uFahrrad/tandem-devkit/project-lib/3dmodels/hub-wire-connector.step

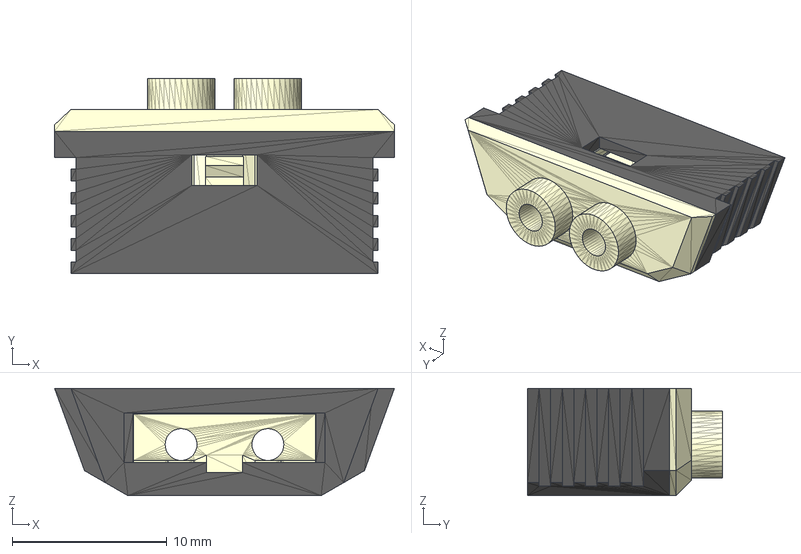
[picture p1: CAD file, 2022-06-10]
project-lib/3dmodels/hub-wire-connector.step
22.0 x 12.6 x 6.95 mm
Cover001 (Solid)
Contact_housing001 (Solid)
