uFahrrad/tandem-devkit/tandem-devkit.kicad_pcb

## KiCad design tandem-devkit.kicad_pcb (2022-06-21)

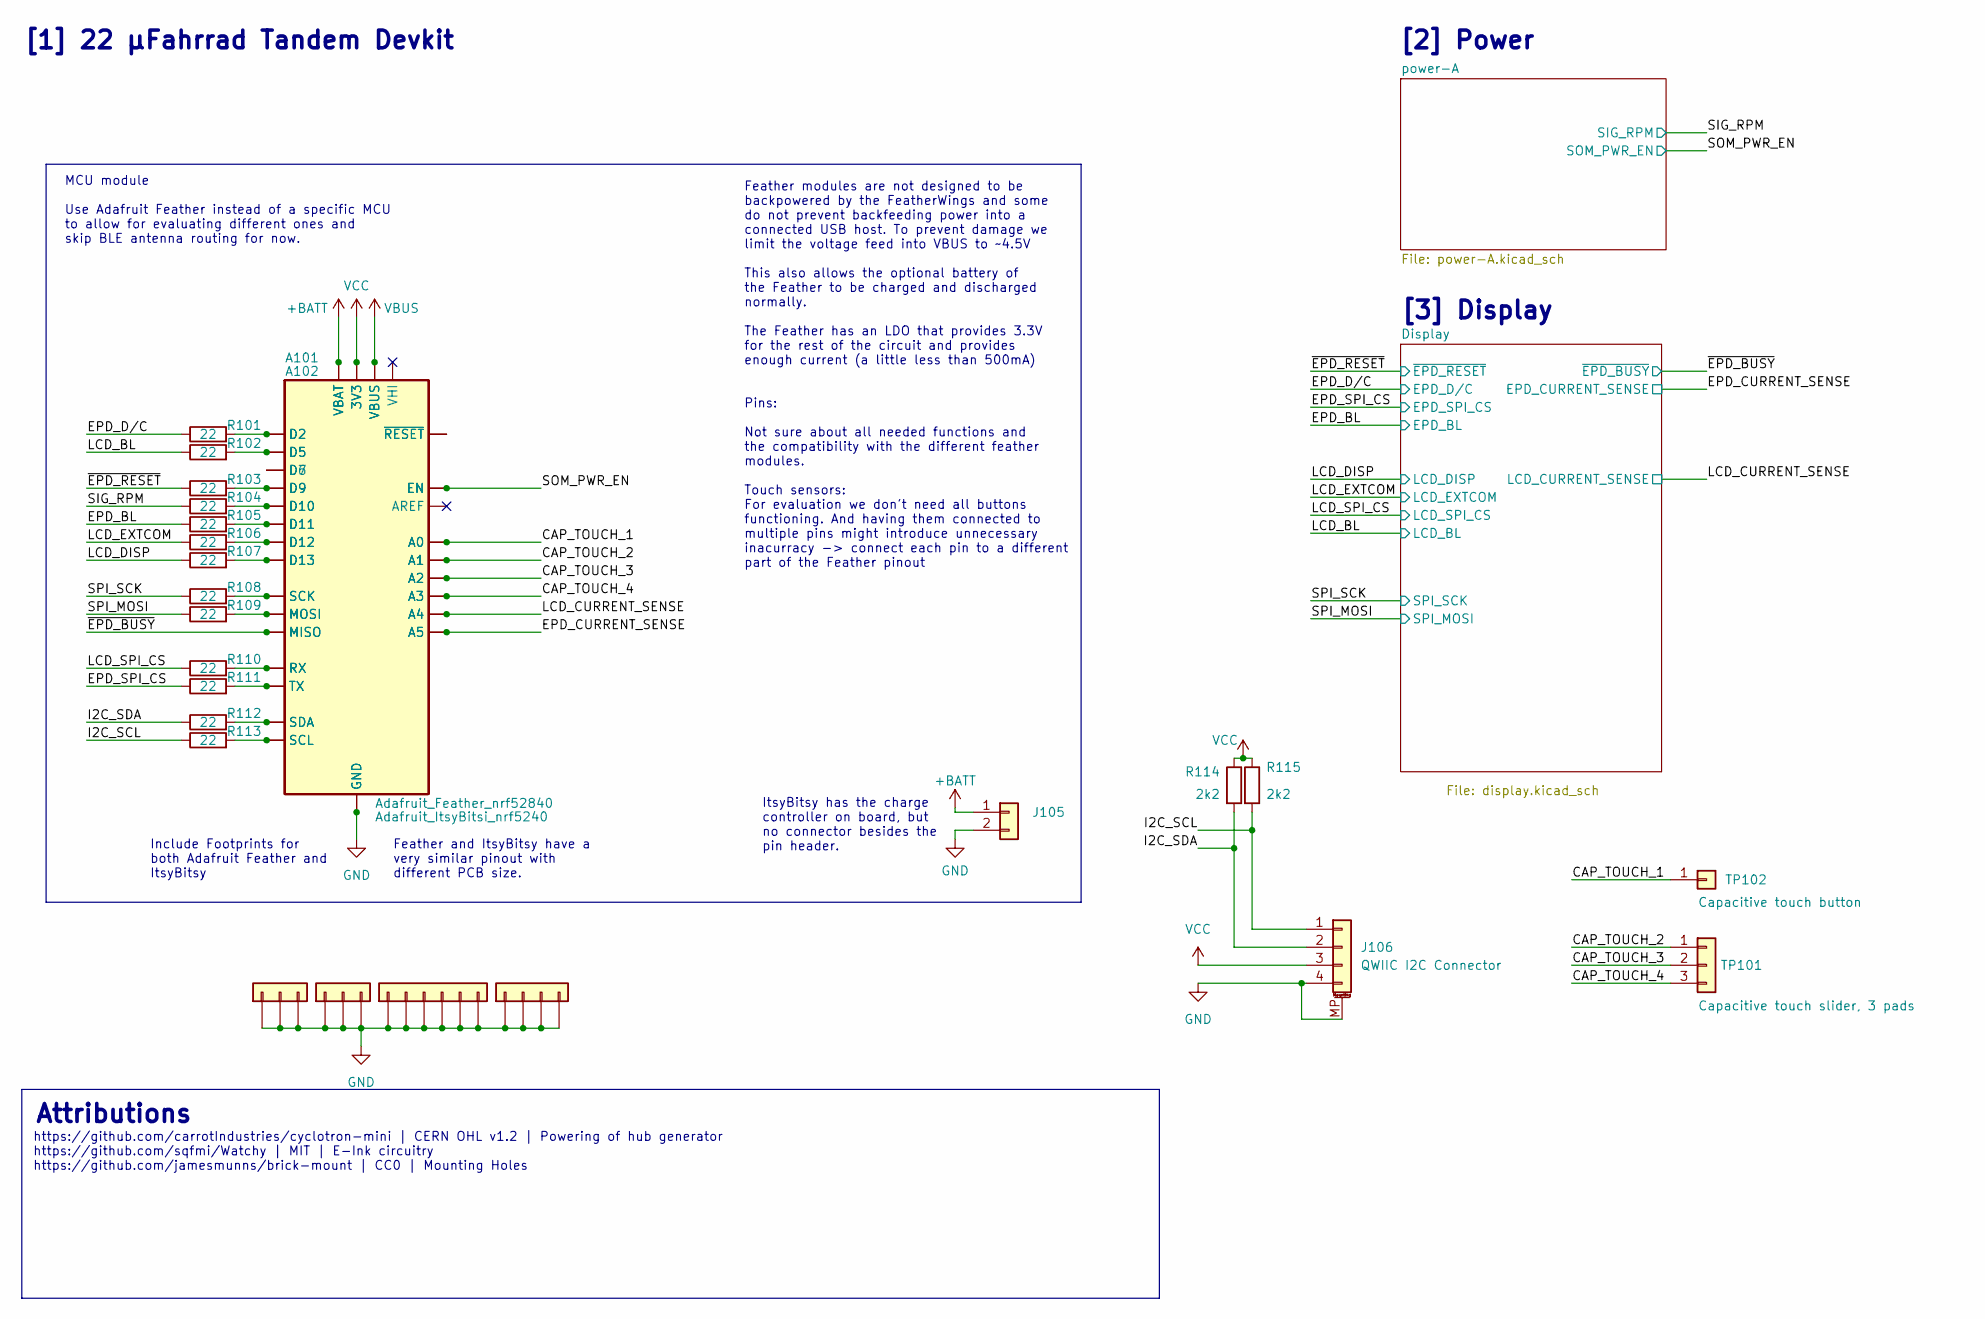
[picture p2: schematic tandem-devkit.kicad_sch, 22 μFahrrad Tandem Devkit]

Parts:
A101: Adafruit_ItsyBitsi_nrf5240; Adafruit_ItsyBitsy-nrf52840
A102: Adafruit_Feather_nrf52840; Adafruit_Feather
J101, J102: Conn_01x03; brick-1x3
J103: Conn_01x06; brick-1x6
J104: Conn_01x04; brick-2x2
J105: Conn_01x02; JST_PH_B2B-PH-K_1x02_P2.00mm_Vertical; JLCPCB C173752
J106: QWIIC I2C Connector; JST_SHL_SM04B-SHLS-TF_1x04-1MP_P1.00mm_Horizontal; JLCPCB C145956
R101, R102, R103, R104, R105, R106, R107, R108, R109, R110, R111, R112, R113: 22; R_0603_1608Metric; LCSC C23345
R114, R115: 2k2; R_0603_1608Metric; LCSC C4190
TP101: Capacitive touch slider, 3 pads; TouchSlider-3_30x13mm-covered
TP102: Capacitive touch button; CapBtn_Board_edge

Connections:
+BATT: A101.28 (VBAT), A102.28 (VBAT), J105.1
/CAP_TOUCH_1: A101.5 (A0), A102.5 (A0), TP102.1
/CAP_TOUCH_2: A101.6 (A1), A102.6 (A1), TP101.1; also elsewhere on the board
/CAP_TOUCH_3: A101.7 (A2), A102.7 (A2), TP101.2; also elsewhere on the board
/CAP_TOUCH_4: A101.8 (A3), A102.8 (A3), TP101.3; also elsewhere on the board
/EPD_BL: R105.1; also elsewhere on the board
/EPD_CURRENT_SENSE: A101.10 (A5), A102.10 (A5); also elsewhere on the board
/EPD_D/C: R101.1; also elsewhere on the board
/EPD_SPI_CS: R111.1; also elsewhere on the board
/I2C_SCL: J106.1, R113.1, R115.2
/I2C_SDA: J106.2, R112.1, R114.2
/LCD_BL: R102.1; also elsewhere on the board
/LCD_CURRENT_SENSE: A101.9 (A4), A102.9 (A4); also elsewhere on the board
/LCD_DISP: R107.1; also elsewhere on the board
/LCD_EXTCOM: R106.1; also elsewhere on the board
/LCD_SPI_CS: R110.1; also elsewhere on the board
/SIG_RPM: R104.1; also elsewhere on the board
/SOM_PWR_EN: A101.3 (EN), A102.27 (EN); also elsewhere on the board
/SPI_MOSI: R109.1; also elsewhere on the board
/SPI_SCK: R108.1; also elsewhere on the board
/~EPD_BUSY: A101.13 (MISO), A102.13 (MISO); also elsewhere on the board
/~EPD_RESET: R103.1; also elsewhere on the board
GND: A101.27 (GND), A102.4 (GND), J101.1, J101.2, J101.3, J102.1, J102.2, J102.3, J103.1, J103.2, J103.3, J103.4, J103.5, J103.6, J104.1, J104.2, J104.3, J104.4, J105.2, J106.4, J106.MP (MountPin); also elsewhere on the board
unnamed: A101.1 (~RESET), A102.1 (~RESET)
unnamed: A101.11 (SCK), A102.11 (SCK), R108.2
unnamed: A101.12 (MOSI), A102.12 (MOSI), R109.2
unnamed: A101.14 (D2), A102.16 (D2), R101.2
unnamed: A101.15 (RX), A102.14 (RX), R110.2
unnamed: A101.16 (TX), A102.15 (TX), R111.2
unnamed: A101.17 (SDA), A102.17 (SDA), R112.2
unnamed: A101.18 (SCL), A102.18 (SCL), R113.2
unnamed: A101.19 (D5), A102.19 (D5), R102.2
unnamed: A101.20 (D7), A102.20 (D6)
unnamed: A101.21 (D9), A102.21 (D9), R103.2
unnamed: A101.22 (D10), A102.22 (D10), R104.2
unnamed: A101.23 (D11), A102.23 (D11), R105.2
unnamed: A101.24 (D12), A102.24 (D12), R106.2
unnamed: A101.25 (D13), A102.25 (D13), R107.2
VBUS: A101.26 (VBUS), A102.26 (VBUS); also elsewhere on the board
VCC: A101.2 (3V3), A102.2 (3V3), J106.3, R114.1, R115.1; also elsewhere on the board

Notes on the sheet:
Include Footprints for both Adafruit Feather and ItsyBitsy
ItsyBitsy has the charge controller on board, but no connector besides the pin header.
[2] Power
https://github.com/carrotIndustries/cyclotron-mini | CERN OHL v1.2 | Powering of hub generator https://github.com/sqfmi/Watchy | MIT | E-Ink circuitry https://github.com/jamesmunns/brick-mount | CC0 | Mounting Holes
MCU module Use Adafruit Feather instead of a specific MCU to allow for evaluating different ones and skip BLE antenna routing for now.
[3] Display
Attributions
Feather and ItsyBitsy have a very similar pinout with different PCB size.
Pins: Not sure about all needed functions and the compatibility with the different feather modules. Touch sensors: For evaluation we don't need all buttons functioning. And having them connected to multiple pins might introduce unnecessary inacurracy -> connect each pin to a different part of the F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
[1] 22 μFahrrad Tandem Devkit
Feather modules are not designed to be backpowered by the FeatherWings and some do not prevent backfeeding power into a connected USB host. To prevent damage we limit the voltage feed into VBUS to ~4.5V This also allows the optional battery of the Feather to be charged and discharged normally. The 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

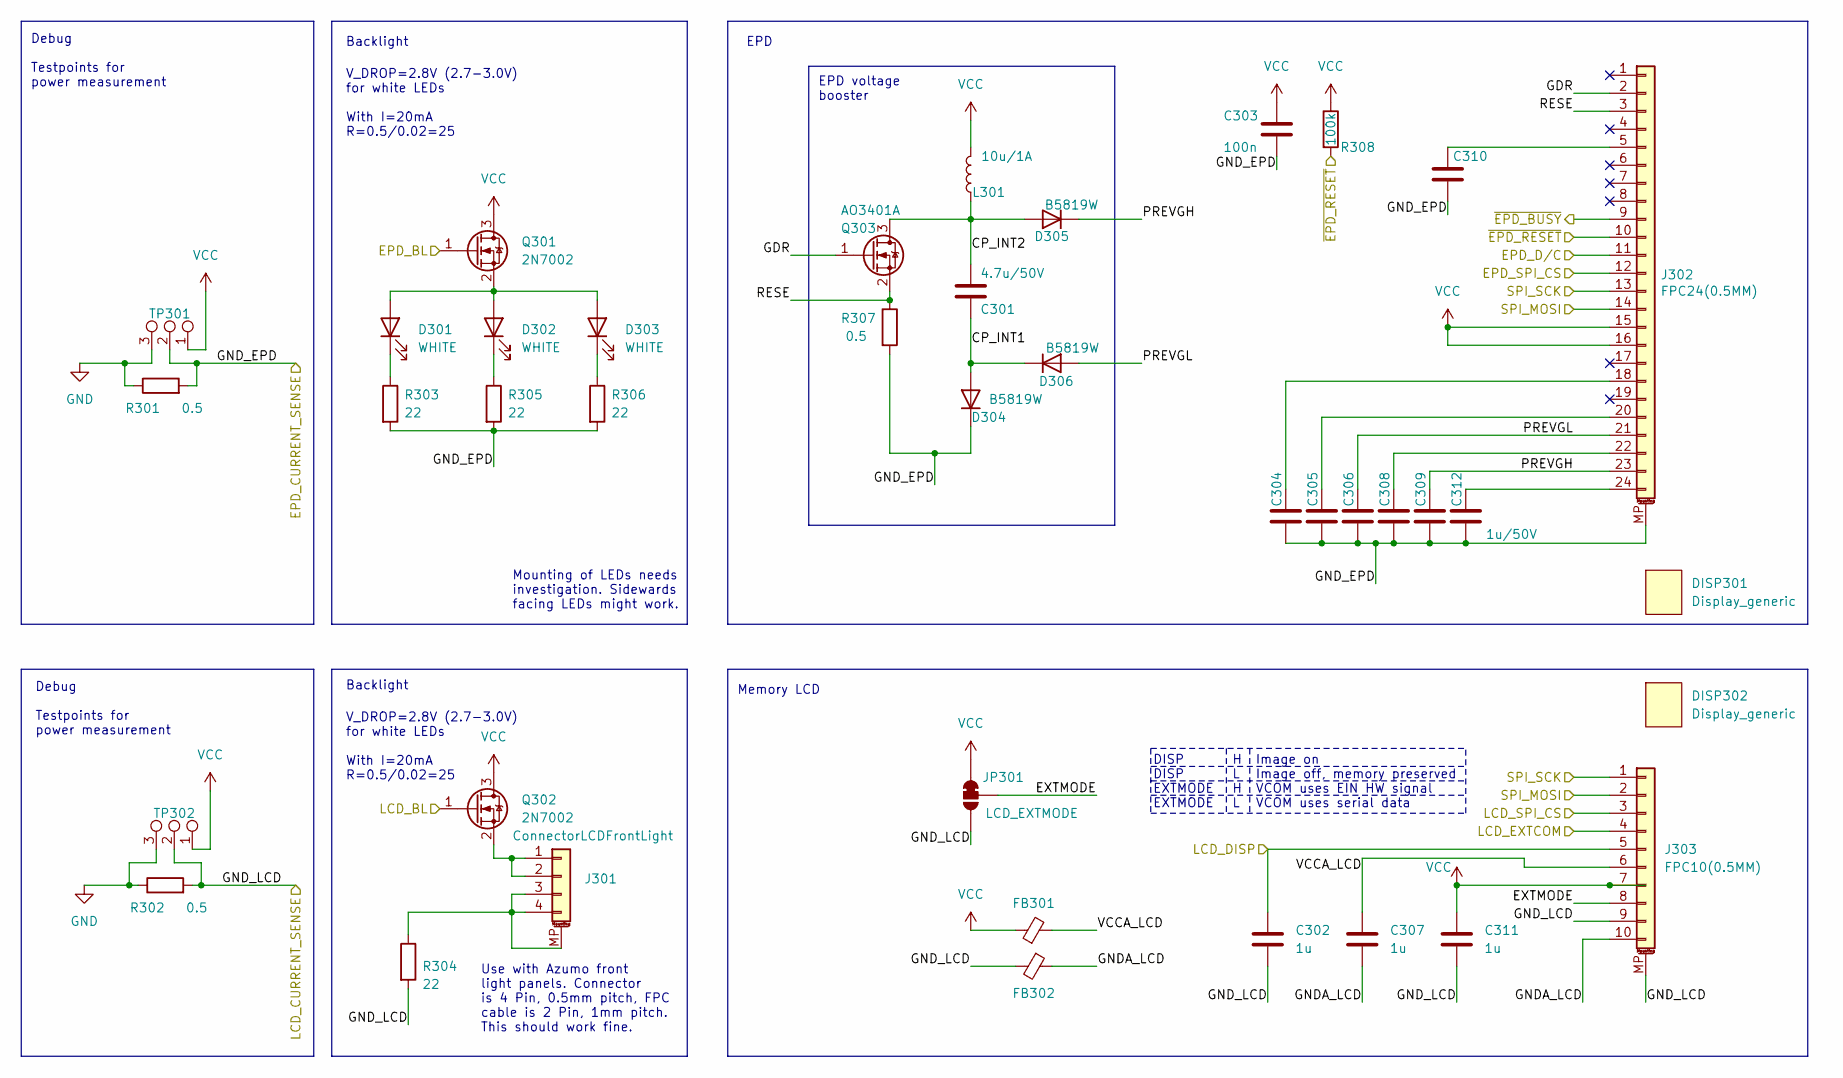
[picture p3: schematic display.kicad_sch, 22 μFahrrad Tandem Devkit - Display]

Parts:
C301: 4.7u/50V; C_1206_3216Metric; LCSC C29823
C302, C307, C311: 1u; C_0603_1608Metric; LCSC C15849
C303: 100n; C_0603_1608Metric; LCSC C14663
C304, C305, C306, C308, C309, C310, C312: 1u/50V; C_0603_1608Metric; LCSC C15849
D301, D302, D303: WHITE; LED_sidemount_C205440; JLCPCB C965863
D304, D305, D306: B5819W; D_SOD-123; JLCPCB C8598
DISP301, DISP302: Display_generic; 154_Epaper_Display
FB301, FB302: FerriteBead_Small; R_0805_2012Metric; JLCPCB C1017
J301: ConnectorLCDFrontLight; jlcpcb-C11047_FFC_1x04-1MP_P0.50mm_Horizontal; JLCPCB C11047
J302: FPC24(0.5MM); jlcpcb-C11057_FFC_1x24-1MP_P0.50mm_Horizontal; JLCPCB C11057
J303: FPC10(0.5MM); jlcpcb-C11050_FFC_1x10-1MP_P0.50mm_Horizontal; JLCPCB C11050
JP301: LCD_EXTMODE; SolderJumper-3_P1.3mm_Bridged12_RoundedPad1.0x1.5mm
L301: 10u/1A; L_4.0x4.0_H3; JLCPCB C38117
Q301, Q302: 2N7002; SOT-23; JLCPCB C8545
Q303: AO3401A; SOT-23; JLCPCB C15127
R301, R302: 0.5; R_0805_2012Metric; JLCPCB C25271
R303, R304, R305, R306: 22; R_0603_1608Metric; LCSC C23345
R307: 0.5; R_0805_2012Metric; LCSC C28319
R308: 100k; R_0603_1608Metric; LCSC C25803
TP301, TP302: TestPoint_3Pole; TestPoint_1x03_P1.27mm

Connections:
/Display/CP_INT1: C301.2, D304.2 (A), D306.1 (K)
/Display/CP_INT2: C301.1, D305.2 (A), L301.1, Q303.3 (D)
/Display/EXTMODE: J303.8, JP301.2 (C)
/Display/GDR: J302.2, Q303.1 (G)
/Display/GNDA_LCD: C307.2, FB302.1, J303.10
/Display/PREVGH: C309.2, D305.1 (K), J302.23
/Display/PREVGL: C306.2, D306.2 (A), J302.21
/Display/RESE: J302.3, Q303.2 (S), R307.1
/Display/VCCA_LCD: C307.1, FB301.2, J303.6
/EPD_BL: Q301.1 (G); also elsewhere on the board
/EPD_CURRENT_SENSE: C303.2, C304.1, C305.1, C306.1, C308.1, C309.1, C310.2, C312.1, D304.1 (K), J302.MP (MountPin), R301.2, R303.2, R305.2, R306.2, R307.2, TP301.2; also elsewhere on the board
/EPD_D/C: J302.11; also elsewhere on the board
/EPD_SPI_CS: J302.12; also elsewhere on the board
/LCD_BL: Q302.1 (G); also elsewhere on the board
/LCD_CURRENT_SENSE: C302.2, C311.2, FB302.2, J303.9, J303.MP (MountPin), JP301.3 (B), R302.2, R304.2, TP302.2; also elsewhere on the board
/LCD_DISP: C302.1, J303.5; also elsewhere on the board
/LCD_EXTCOM: J303.4; also elsewhere on the board
/LCD_SPI_CS: J303.3; also elsewhere on the board
/SPI_MOSI: J302.14, J303.2; also elsewhere on the board
/SPI_SCK: J302.13, J303.1; also elsewhere on the board
/~EPD_BUSY: J302.9; also elsewhere on the board
/~EPD_RESET: J302.10, R308.2; also elsewhere on the board
GND: R301.1, R302.1, TP301.3, TP302.3; also elsewhere on the board
unnamed: C304.2, J302.18
unnamed: C305.2, J302.20
unnamed: C308.2, J302.22
unnamed: C310.1, J302.5
unnamed: C312.2, J302.24
unnamed: D301.1 (K), R303.1
unnamed: D301.2 (A), D302.2 (A), D303.2 (A), Q301.2 (S)
unnamed: D302.1 (K), R305.1
unnamed: D303.1 (K), R306.1
unnamed: J301.1, J301.2, Q302.2 (S)
unnamed: J301.3, J301.4, J301.MP (MountPin), R304.1
VCC: C303.1, C311.1, FB301.1, J302.15, J302.16, J303.7, JP301.1 (A), L301.2, Q301.3 (D), Q302.3 (D), R308.1, TP301.1, TP302.1; also elsewhere on the board

Notes on the sheet:
Image on Image off, memory preserved VCOM uses EIN HW signal VCOM uses serial data
H L H L
V_DROP=2.8V (2.7-3.0V) for white LEDs With I=20mA R=0.5/0.02=25
Use with Azumo front light panels. Connector is 4 Pin, 0.5mm pitch, FPC cable is 2 Pin, 1mm pitch. This should work fine.
Debug Testpoints for power measurement
Mounting of LEDs needs investigation. Sidewards facing LEDs might work.
Backlight
EPD
DISP DISP EXTMODE EXTMODE
Memory LCD
EPD voltage booster

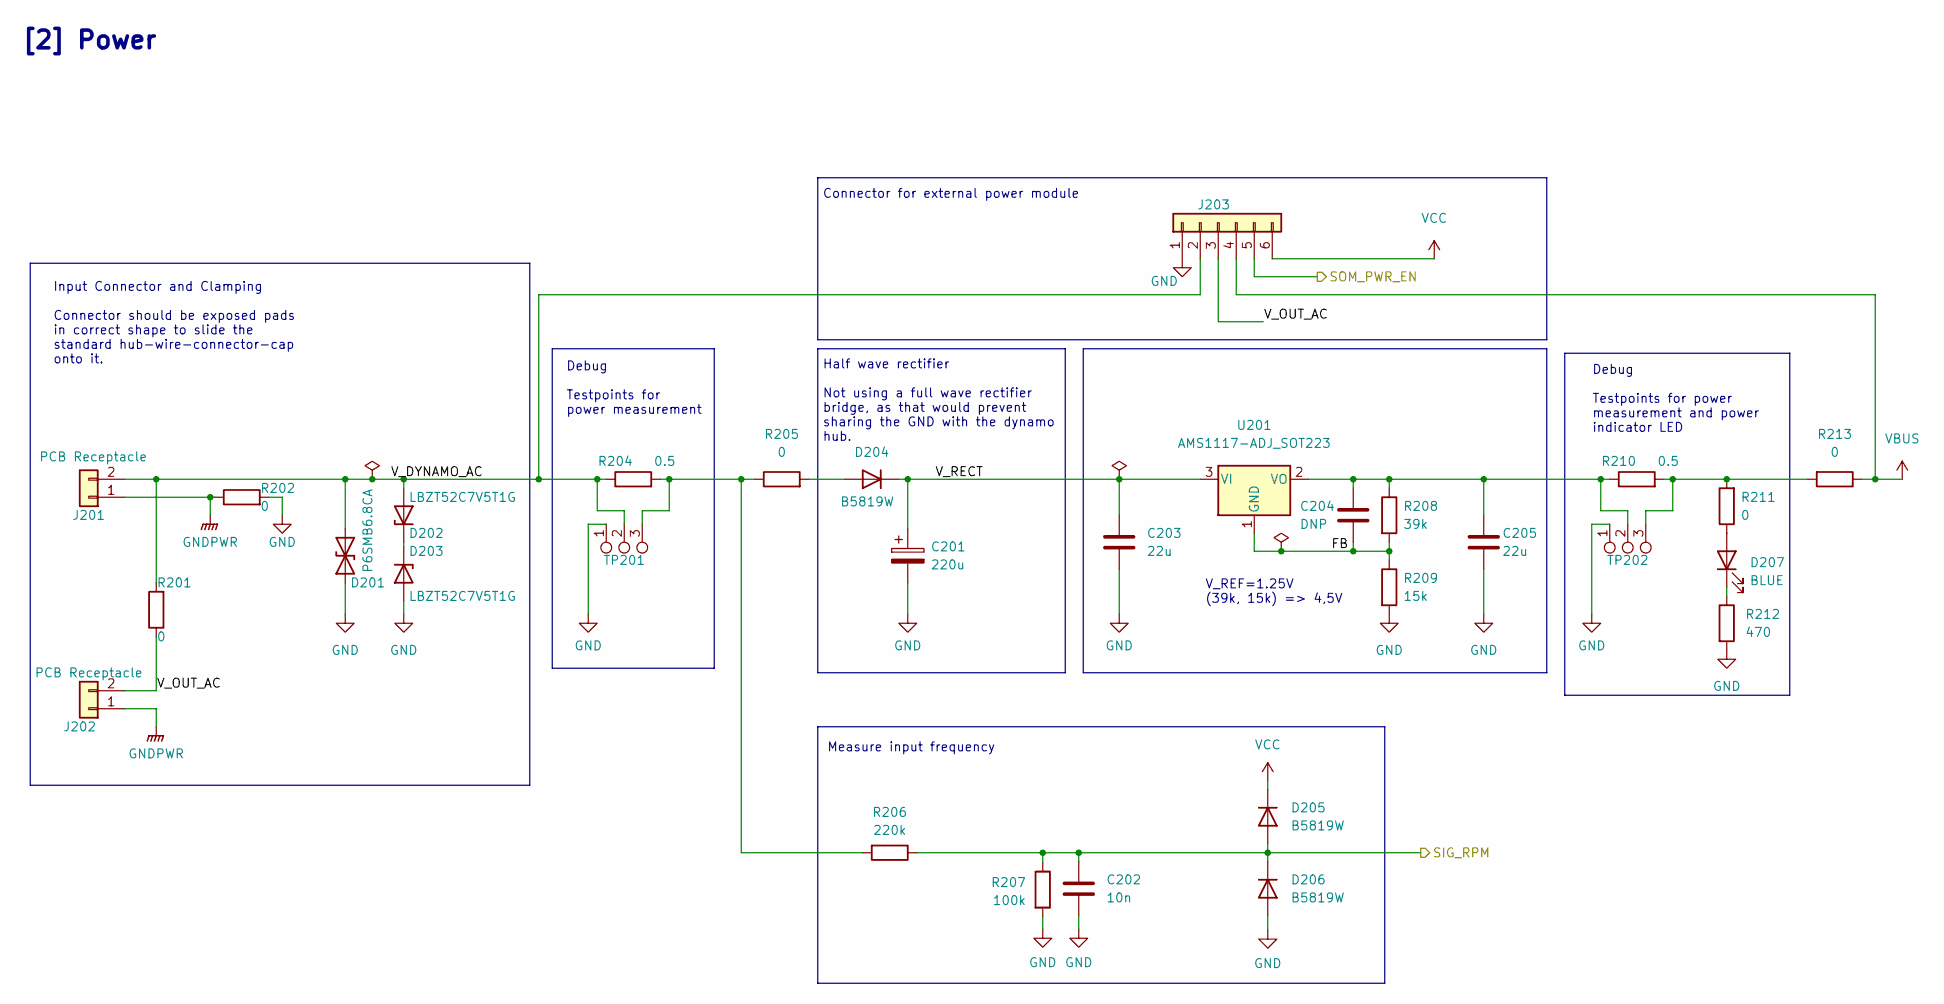
[picture p4: schematic power-A.kicad_sch, 22 μFahrrad Tandem Devkit - Power]

Parts:
C201: 220u; CP_EIA-7343-43_Kemet-X; JLCPCB C117040
C202: 10n; C_0603_1608Metric; LCSC C57112
C203, C205: 22u; C_1206_3216Metric; JLCPCB C12891
C204: DNP; C_0603_1608Metric
D201: P6SMB6.8CA; D_SMB; JLCPCB C78395
D202, D203: LBZT52C7V5T1G; D_SOD-123; JLCPCB C12760
D204, D205, D206: B5819W; D_SOD-123; JLCPCB C8598
D207: BLUE; LED_0603_1608Metric; JLCPCB C2293
J201, J202: PCB Receptacle; shimano-hub-generator-connector
J203: Conn_01x06; powermodule
R201, R202, R205, R211, R213: 0; R_0805_2012Metric_Pad1.20x1.40mm_HandSolder; LCSC C17477
R204, R210: 0.5; R_0805_2012Metric; JLCPCB C25271
R206: 220k; R_0603_1608Metric; LCSC C22961
R207: 100k; R_0603_1608Metric; LCSC C25803
R208: 39k; R_0603_1608Metric; LCSC C23153
R209: 15k; R_0603_1608Metric; LCSC C22809
R212: 470; R_0603_1608Metric; LCSC C23179
TP201, TP202: TestPoint_3Pole; TestPoint_1x03_P1.27mm
U201: AMS1117-ADJ_SOT223; SOT-223-3_TabPin2; JLCPCB C347224

Connections:
/SIG_RPM: C202.1, D205.2 (A), D206.1 (K), R206.1, R207.1; also elsewhere on the board
/SOM_PWR_EN: J203.5; also elsewhere on the board
/power-A/FB: C204.2, R208.2, R209.1, U201.1 (GND)
/power-A/V_DYNAMO_AC: D201.2 (A2), D202.2 (A), J201.2, J203.2, R201.2, R204.1, TP201.2
/power-A/V_OUT_AC: J202.2, J203.3, R201.1
/power-A/V_RECT: C201.1, C203.1, D204.1 (K), U201.3 (VI)
GND: C201.2, C202.2, C203.2, C205.2, D201.1 (A1), D203.2 (A), D206.2 (A), J203.1, R202.2, R207.2, R209.2, R212.2, TP201.1, TP202.1; also elsewhere on the board
GNDPWR: J201.1, J202.1, R202.1
unnamed: C204.1, C205.1, R208.1, R210.1, TP202.2, U201.2 (VO)
unnamed: D202.1 (K), D203.1 (K)
unnamed: D204.2 (A), R205.2
unnamed: D207.1 (K), R212.1
unnamed: D207.2 (A), R211.1
unnamed: R204.2, R205.1, R206.2, TP201.3
unnamed: R210.2, R211.2, R213.2, TP202.3
VBUS: J203.4, R213.1; also elsewhere on the board
VCC: D205.1 (K), J203.6; also elsewhere on the board

Notes on the sheet:
Debug Testpoints for power measurement
V_REF=1.25V (39k, 15k) => 4,5V
Connector for external power module
Debug Testpoints for power measurement and power indicator LED
Half wave rectifier Not using a full wave rectifier bridge, as that would prevent sharing the GND with the dynamo hub.
Measure input frequency
Input Connector and Clamping Connector should be exposed pads in correct shape to slide the standard hub-wire-connector-cap onto it.
[2] Power

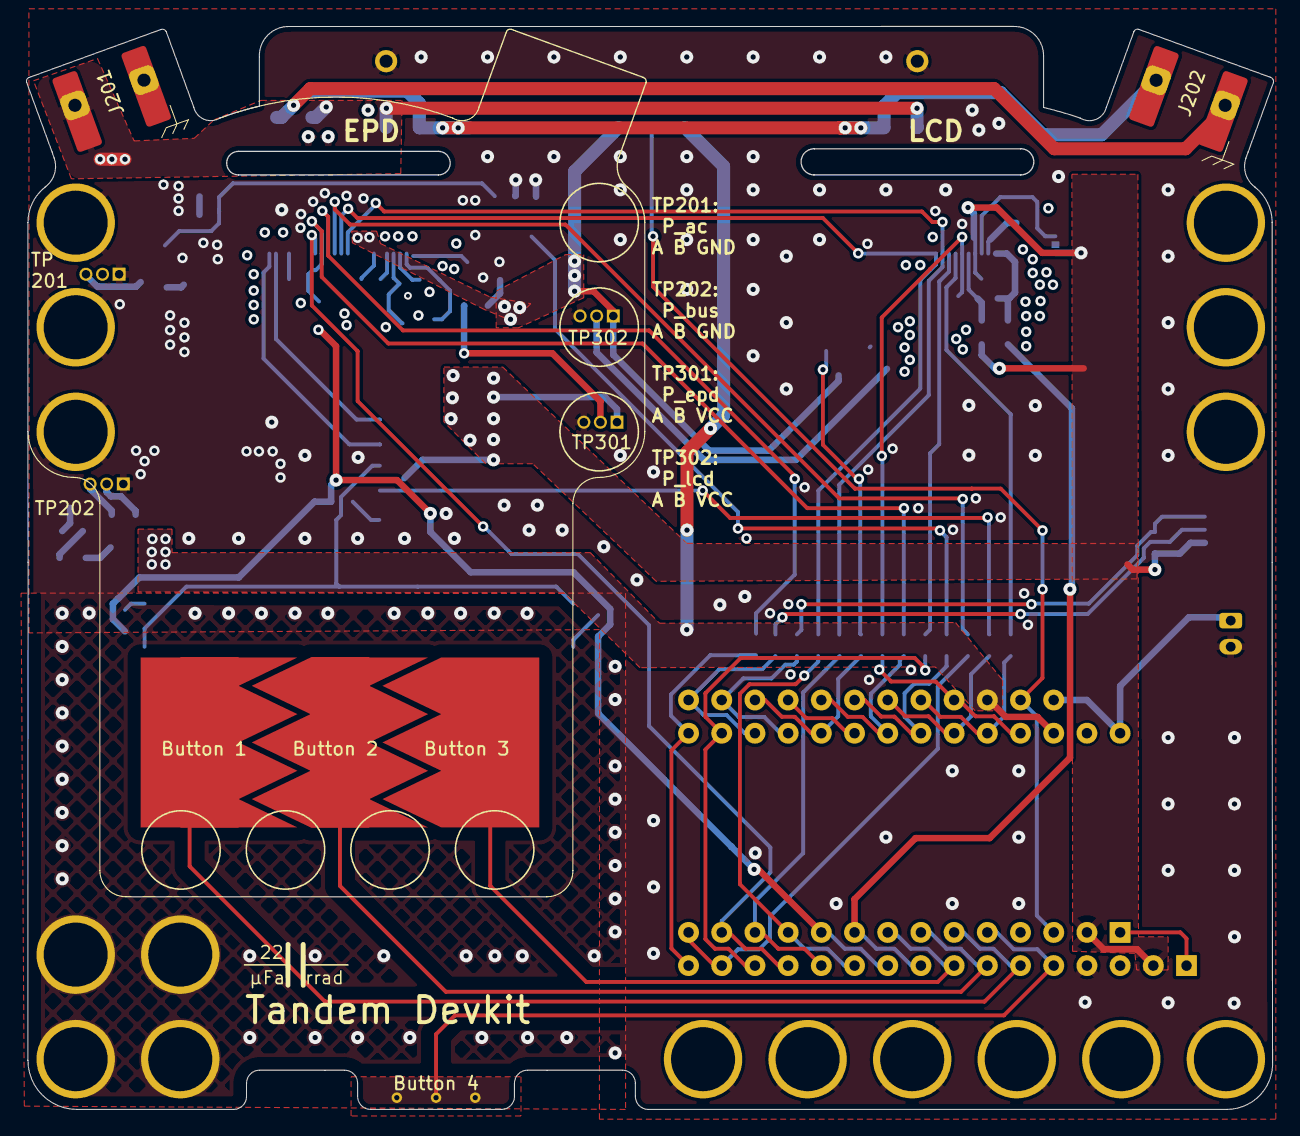
[picture p5: board tandem-devkit.kicad_pcb from above]

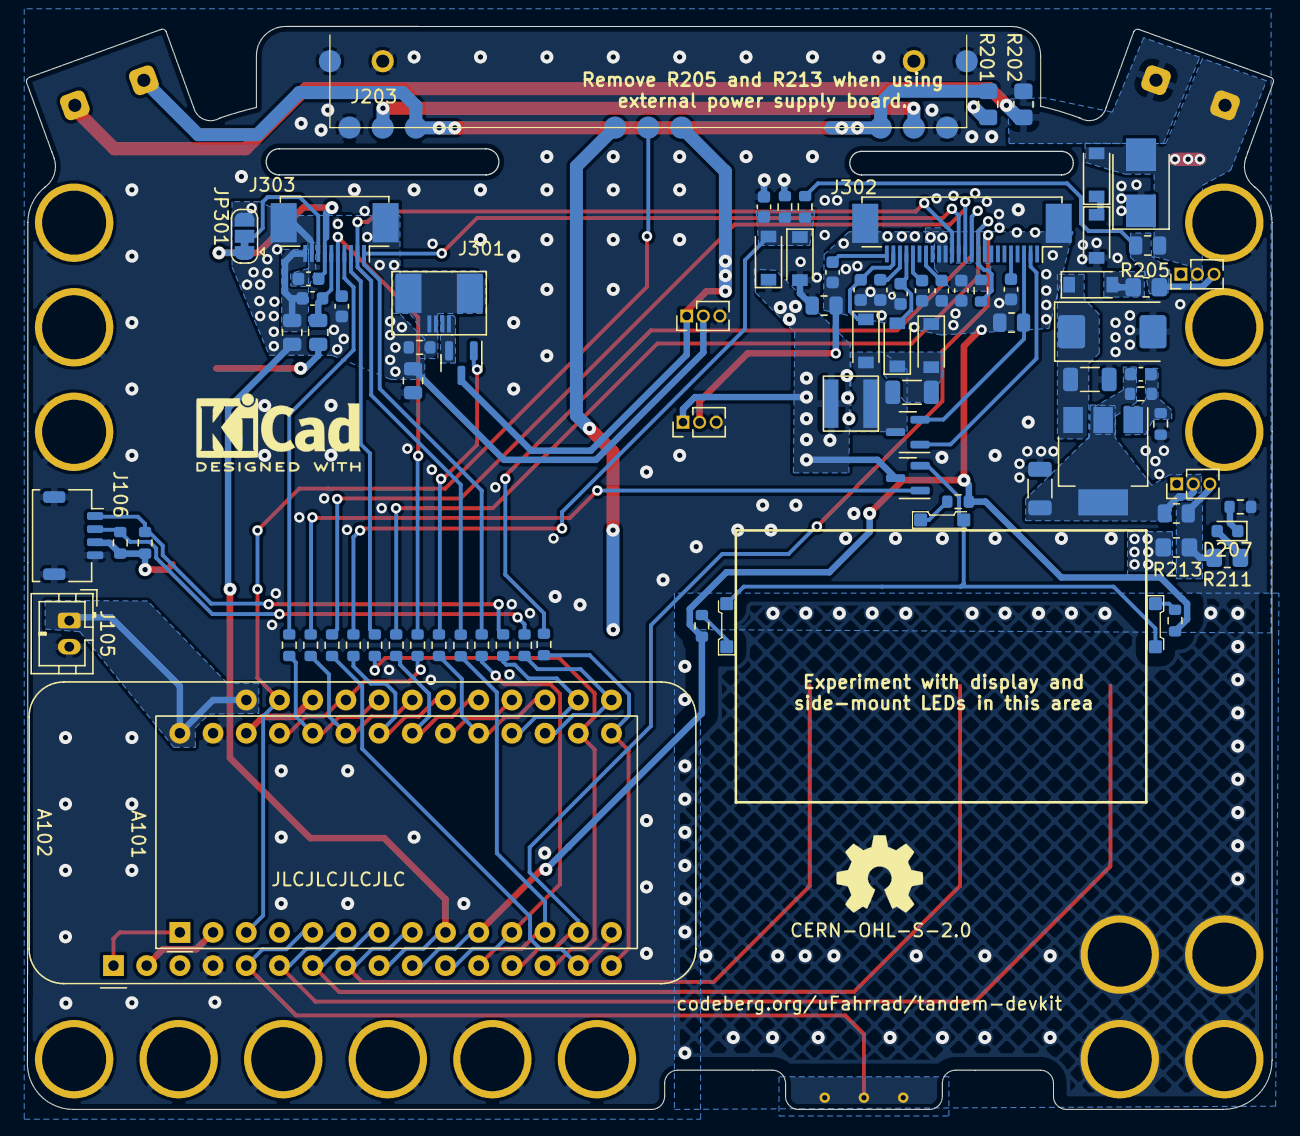
[picture p6: board tandem-devkit.kicad_pcb from below]

Board: 4 copper layers, 95.4 x 82.9 mm, 99 parts (91 on the bottom side), 72 nets.

Other parts of the board:
22uFahrrad-Logo: LOGO
BoardOutline: μFahrrad-DevTandem-Shape
KiCAD-Logo: KiCad-Logo2_5mm_SilkScreen
OSHW-Logo: OSHW-Symbol_6.7x6mm_SilkScreen
locked: Capacitive touch slider, 3 pads; TouchSlider-3_30x13mm-covered

Their connections:
/CAP_TOUCH_2: locked.1; also elsewhere on the board
/CAP_TOUCH_3: locked.2; also elsewhere on the board
/CAP_TOUCH_4: locked.3; also elsewhere on the board
