uFahrrad/tandem-devkit/(commit log)

2022-06-10 Initial Commit with kicad-git-filters setup
2022-06-10 Add kicad_pcb-diff tooling
2022-06-10 Addd schematic
    [display.kicad_sch, power-A.kicad_sch, tandem-devkit.kicad_sch]
2022-06-10 Add WIP PCB layout
    [tandem-devkit.kicad_pcb]
2022-06-10 Add project library
    [hub-wire-connector.step]
2022-06-20 gitginore kicad_prl file
2022-06-20 Pre routing: footprints&parts
    [display.kicad_sch, power-A.kicad_sch, tandem-devkit.kicad_pcb, tandem-devkit.kicad_sch]
2022-06-20 Schematics: Add mountingpins to connectors, remove ERC warnings for alternate parts
    [display.kicad_sch, power-A.kicad_sch, tandem-devkit.kicad_sch]
2022-06-20 ERC: allow multiple net names for display GND/current_sense nets
2022-06-20 footprints: add mounting pins to FPC connectors
2022-06-20 PCB: include schematic changes
    [tandem-devkit.kicad_pcb]
2022-06-20 schematic: replace LCD Light with connector for Azumo light panel
    [display.kicad_sch, power-A.kicad_sch, tandem-devkit.kicad_sch]
2022-06-20 footprints: add needed footprints for backlight LED and connector
2022-06-20 schematic: add placeholders for the actual displays
    Also fixup GND_LCD for Extmode SolderJumper.
    [display.kicad_sch, tandem-devkit.kicad_sch]
2022-06-20 schematic: GND_EPD fixups
    [display.kicad_sch, tandem-devkit.kicad_sch]
2022-06-20 footprints: fixup courtyard of inductors
2022-06-20 PCB: rough placement, 1/x
    [tandem-devkit.kicad_pcb]
2022-06-20 schematic: cleanups and diode selection
    [display.kicad_sch, power-A.kicad_sch, tandem-devkit.kicad_sch]
2022-06-20 PCB: rough placement, 2/x
    [tandem-devkit.kicad_pcb]
2022-06-20 PCB: rough placement, 3/x
    [tandem-devkit.kicad_pcb]
2022-06-20 footprints: define testpoint with smaller courtyard
    [display.kicad_sch, power-A.kicad_sch, tandem-devkit.kicad_sch]
2022-06-20 schematic: fixup reference designator positions
    [tandem-devkit.kicad_sch]
2022-06-20 schematic: add another capacitive touch point, reorder feather pins
    [display.kicad_sch, tandem-devkit.kicad_sch]
2022-06-20 PCB: flip feather so it can be soldered directly underneath the board
    [tandem-devkit.kicad_pcb]
2022-06-20 PCB: update netlist
    [tandem-devkit.kicad_pcb]
2022-06-20 PCB: reorder a little, move all feather/itsy-bitsy internal connections to single copper layer
    [tandem-devkit.kicad_pcb]
2022-06-20 PCB: import JLCPCB 4-Layer board settings
    [tandem-devkit.kicad_pcb]
2022-06-20 PCB: fix DRC
    - reduced track clearance for power and default net to fit between
    the pads of connectors
    - rearranged epaper driver to adhere to DRC rules
    - connected Feather and ItsyBitsy footprint and the related resistors
    [tandem-devkit.kicad_pcb]
2022-06-20 schematic: fix LCD VCCA decoupling capacitor
    [display.kicad_sch]
2022-06-20 PCB: route display connectors
    [tandem-devkit.kicad_pcb]
2022-06-20 schematic: switch EPD/LCD current sense lines to ease routing
    [tandem-devkit.kicad_sch]
2022-06-20 PCB: routing mostly done
    [tandem-devkit.kicad_pcb]
2022-06-20 PCB: fix most of zone priorities and connections
    [tandem-devkit.kicad_pcb]
2022-06-20 schematic: assign connector footprint
    [power-A.kicad_sch, tandem-devkit.kicad_sch]
2022-06-20 PCB/footprints: Update shape and connector
    [tandem-devkit.kicad_pcb]
2022-06-20 Exchange brick-mount holes with actual footprint, connect holes to gnd
    [display.kicad_sch, tandem-devkit.kicad_pcb, tandem-devkit.kicad_sch]
2022-06-20 connect everything except the capacitive touch sensors
    [tandem-devkit.kicad_pcb, tandem-devkit.kicad_sch]
2022-06-20 prepare for touch button routing
    [tandem-devkit.kicad_pcb, tandem-devkit.kicad_sch]
2022-06-20 PCB: route cap buttons and adjust zones
    [tandem-devkit.kicad_sch]
2022-06-20 PCB: align testpoint orientation with silkscreen
2022-06-20 PCB: Touchbuttons and silkscreen adaptions
    [tandem-devkit.kicad_sch]
2022-06-20 Footprints: add forgotten footprints to git
2022-06-20 Schematic: more 0R resistors and power module connector
    [power-A.kicad_sch, tandem-devkit.kicad_sch]
2022-06-20 PCB: add powermodule and reroute some stuff
    [power-A.kicad_sch, tandem-devkit.kicad_pcb, tandem-devkit.kicad_sch]
2022-06-20 Ficup column name for JLCPCB/LCSC part no
    [display.kicad_sch, power-A.kicad_sch, tandem-devkit.kicad_pcb, tandem-devkit.kicad_sch]
2022-06-20 PCB: prepare JLC parts list for manufacturing
    [tandem-devkit.kicad_pcb]
2022-06-20 PCB: add GND stitching vias
    [tandem-devkit.kicad_pcb]
2022-06-20 schematic: change i2c pull-ups to 2k2
    As mentioned as "Phil's Lab" mentions as his suggested value
    [tandem-devkit.kicad_sch]
2022-06-20 PCB: sync with schematic
    [tandem-devkit.kicad_pcb]
2022-06-20 move power module intput directly to V_DYNAMO_AC to ease routing
    [power-A.kicad_sch, tandem-devkit.kicad_pcb]
2022-06-20 PCB: adapt GND zone to board
    [tandem-devkit.kicad_pcb]
2022-06-20 Mark some parts as 'exclude from bom'
    [display.kicad_sch, power-A.kicad_sch, tandem-devkit.kicad_pcb, tandem-devkit.kicad_sch]
2022-06-20 PCB: resolve silkscreen/via overlap
    [tandem-devkit.kicad_pcb]
2022-06-20 fixups for silkscreen and 'exclude from bom'
    [tandem-devkit.kicad_pcb]
2022-06-20 Components: select JLCPCB basic components
    [display.kicad_sch, tandem-devkit.kicad_pcb, tandem-devkit.kicad_sch]
2022-06-20 Schematic: BOM consolidation and JLCPCB part no annotation
    [display.kicad_sch, power-A.kicad_sch, tandem-devkit.kicad_sch]
2022-06-20 PCB: pull updates from schematic
    [tandem-devkit.kicad_pcb]
2022-06-20 PCB: flip brickmount footprints so courtyard applies to back of PCB
    [tandem-devkit.kicad_pcb]
2022-06-20 PCB: move components out of brickmount courtyards
    [tandem-devkit.kicad_pcb]
2022-06-20 PCB: add logos and URL
    [tandem-devkit.kicad_pcb]
2022-06-20 Update drawing sheets title block
    [display.kicad_sch, power-A.kicad_sch, tandem-devkit.kicad_pcb, tandem-devkit.kicad_sch]
2022-06-20 PCB: mark logos as not-in-schematic
    [tandem-devkit.kicad_pcb]
2022-06-20 schematic: rearrange main page a little
    [tandem-devkit.kicad_sch]
2022-06-20 PCB: add designator for JLC order number
    [tandem-devkit.kicad_pcb]
2022-06-20 exchange backlight LED for one that is actually white and available
    [display.kicad_sch, tandem-devkit.kicad_pcb, tandem-devkit.kicad_sch]
2022-06-20 exchange C to polarized
    [power-A.kicad_sch]
2022-06-21 PCB: update zones
2022-06-21 update power indicator LED to match JLC coponent
    [power-A.kicad_sch, tandem-devkit.kicad_pcb, tandem-devkit.kicad_sch]
2022-06-21 PCB/footprints: fix up FPC connectors
    [tandem-devkit.kicad_pcb]
2022-06-22 Revert "meta: add github action for keeping mirror up to date"
    This reverts commit 79af080966d0dfccbd1cf98be5fe91daaca357ea.
    Switched to using an external repo in the same github organization to
    keep the mirrors updated, so this is not needed anymore.
