uFahrrad/tandem-devkit/(notices)

Notices in the files:
tandem-devkit.kicad_sch:
CERN Open Hardware Licence Version 2 - Strongly Reciprocal
CERN-OHL-S-2.0 https://spdx.org/licenses/CERN-OHL-S-2.0.html
tandem-devkit.kicad_pcb:
CERN-OHL-S-2.0
